AddisonGoolsbee/blindfold-art/(commit log)

2023-10-26 Add UDP Receiver and transmitter, map pitch and yaw (hard coded) into dot location on pygame and draw circles. Also give a prompt and timer
2023-10-26 Add touch sensor and randomize drawing request
2023-10-26 add accelerometer logic
